Riconec/ESP8266-Wi-Fi-RFID/Docs/Diploma/_7 Перелік скорочень.docx

ПЕРЕЛІК УМОВНИХ СКОРОЧЕНЬ, ТЕРМІНІВ

Wi – Wi (англ. «wireless fidelity» - технологія, що дозволяє виконувати передачу даних на високій швидкості без використання проводів через радіо сигнал.

SoC (англ «system-on-a-chip) — дизайн електронної схеми, яка вміщує функціональні складові цілого пристрою на одній мікросхемі.

RFID (англ. radio frequency identification») - спосіб автоматичної ідентифікації об'єктів, в якому за допомогою радіосигналів зчитуються або записуються дані.

OLED (англ. «organic light emitting diode») — світлодіод, випромінюючий електролюмінісцентний шар якого складається з плівки органічної суміші.

SPI (англ. «serial peripheral interface») – послідовний периферійний інтерфейс.

I²C (англ. «inter-integrated circuit» послідовна шина даних для зв'язку інтегральних схем.

UART (англ. «universal asynchronous receiver/transmitter») – універсальний асинхронний приймач/передавач.

ASCII (англ. «american standard code for information interchange») - американський стандартний код для інформаційного обміну.

USB (англ. «universal serial bus») – універсальна послідовна шина.

ДП – друкована плата.

КП – контактна площадка.

КС – координатна сітка.

МК – мікроконтролер.

МО – монтажний отвір.

ПК – персональний комп’ютер.

Зм. Арк. № документа Підпис Дата Арк. 4 ДК01.466429.001 ПЗ
