Riconec/ESP8266-Wi-Fi-RFID/Docs/Diploma/сторінки.docx

1) RFID, I2C, SPI – 7 сторінок
2) Теорія ESP8266 – 7 сторінок
3) Анотація – 3 сторінки
4) Список скорочень – 1 сторінка

----- усього 18 сторінок + 3 А1 + 2 А4

5) Розрахунки електричні та конструкторські – 11 сторінок

---- усього 29 сторінок
