Riconec/ESP8266-Wi-Fi-RFID/Docs/Diploma/_4 ПЗ титул.docx

Пояснювальна записка
до дипломного проекту

на тему:

Київ – 20__ року
