Riconec/ESP8266-Wi-Fi-RFID/Docs/Diploma/ДОДАТОК.docx

Додаток Б

ТЕКСТ ФАЙЛУ MAIN.С

#include "stm32f10x_gpio.h"

#include "wh0802.h"

#include "menu.h"

#define RCC_APB1ENR_INIT (RCC_APB1ENR_TIM2EN | RCC_APB1ENR_TIM3EN | RCC_APB1ENR_TIM6EN)

#define RCC_APB2ENR_INIT (RCC_APB2ENR_IOPAEN | RCC_APB2ENR_IOPBEN | RCC_APB2ENR_IOPCEN | RCC_APB2ENR_AFIOEN | RCC_APB2ENR_USART1EN)

#define GPIOA_CRH_INIT 0x44442222

#define GPIOB_CRL_INIT 0x4a444444

#define GPIOB_CRH_INIT 0x4444a244

#define GPIOC_CRL_INIT 0x44424444

#define GPIOC_CRH_INIT 0x444222a2

#define AFIO_MAPR_INIT (AFIO_MAPR_TIM2_REMAP | AFIO_MAPR_TIM3_REMAP | AFIO_MAPR_USART1_REMAP)

#define USART1_BRR_INIT (0x9c4)

#define USART1_CR1_INIT (USART_CR1_UE | USART_CR1_TE | USART_CR1_RE | USART_CR1_TCIE | USART_CR1_RXNEIE)

#define EXTI_IMR_INIT 0x0000000f

#define EXTI_RTSR_INIT 0x0000000f

#define NVIC_ISER0_INIT (NVIC_ISER_SETENA_6 | NVIC_ISER_SETENA_7 | NVIC_ISER_SETENA_8 | NVIC_ISER_SETENA_9)

#define NVIC_ISER1_INIT (NVIC_ISER_SETENA_5)

uint32_t PrButton = 0;

void MOTOR_Start() {

unsigned int MHSpeed;

unsigned int MLSpeed = 240;

if (!CONTROL.Direction) {

MHSpeed = CONTROL.Speed * 24000 / 100;

TIM3->CCR4 = 23760;

}

else {

MHSpeed = CONTROL.Speed * 24000 / 100;

TIM2->CCR4 = 240;

}

GPIOC->ODR |= (1<<4);

TIM2->CR1 |= TIM_CR1_CEN;

TIM3->CR1 |= TIM_CR1_CEN;

while (MHSpeed >= MLSpeed) {

if (!CONTROL.Direction) TIM2->CCR4 = MLSpeed;

else TIM3->CCR4 = 24000 - MLSpeed;

WH0802_DelayMS(25);

MLSpeed += 240;

}

}

void MOTOR_UpdateSpeed() {

if (!CONTROL.Direction) {

TIM2->CCR4 = CONTROL.Speed * 24000 / 100;

TIM3->CCR4 = 23760;

}

else {

TIM3->CCR4 = (100 - CONTROL.Speed) * 24000 / 100;

TIM2->CCR4 = 240;

}

}

void MOTOR_Stop() {

unsigned int MHSpeed;

unsigned int MLSpeed = 240;

if (!CONTROL.Direction) {

MHSpeed = CONTROL.Speed * 24000 / 100;

TIM3->CCR4 = 23760;

}

else {

MHSpeed = CONTROL.Speed * 24000 / 100;

TIM2->CCR4 = 240;

}

while (MHSpeed >= MLSpeed) {

if (!CONTROL.Direction) TIM2->CCR4 = MHSpeed;

else TIM3->CCR4 = 24000 - MHSpeed;

WH0802_DelayMS(25);

MHSpeed -= 240;

}

GPIOC->ODR &= ~(1<<4);

TIM2->CR1 &= ~TIM_CR1_CEN;

TIM3->CR1 &= ~TIM_CR1_CEN;

}

void MENU_UpdateSpeed(unsigned int Speed) {

CONTROL.VALUE[0][0] = '>';

CONTROL.VALUE[0][4] = (Speed / 10) | 0x30;

CONTROL.VALUE[0][5] = (Speed % 10) | 0x30;

MOTOR_UpdateSpeed();

}

void MENU_UpdateDirection(unsigned int Direction) {

if (!Direction) {

CONTROL.VALUE[1][0] = '>'; CONTROL.VALUE[1][1] = 'f';

CONTROL.VALUE[1][2] = 'o'; CONTROL.VALUE[1][3] = 'r';

CONTROL.VALUE[1][4] = 'w'; CONTROL.VALUE[1][5] = 'a';

CONTROL.VALUE[1][6] = 'r'; CONTROL.VALUE[1][7] = 'd';

}

else {

CONTROL.VALUE[1][0] = '>'; CONTROL.VALUE[1][1] = 'r';

CONTROL.VALUE[1][2] = 'e'; CONTROL.VALUE[1][3] = 'v';

CONTROL.VALUE[1][4] = 'e'; CONTROL.VALUE[1][5] = 'r';

CONTROL.VALUE[1][6] = 's'; CONTROL.VALUE[1][7] = 'e';

}

}

void MENU_Update(unsigned int Button) {

if (Button == 1) {

if (!CONTROL.ItemValue) {

if (CONTROL.CurItem) CONTROL.CurItem = 0;

else CONTROL.CurItem = 1;

}

else {

if (CONTROL.CurItem == 0) {

if (CONTROL.Speed > 5) CONTROL.Speed -= 5;

else CONTROL.Speed = 5;

MENU_UpdateSpeed(CONTROL.Speed);

}

else {

if (CONTROL.Direction) CONTROL.Direction = 0;

else CONTROL.Direction = 1;

MENU_UpdateDirection(CONTROL.Direction);

}

}

}

if (Button == 2) {

if (!CONTROL.ItemValue) {

CONTROL.ItemValue = 1;

CONTROL.ITEM[CONTROL.CurItem][0] = ' ';

CONTROL.VALUE[CONTROL.CurItem][0] = '>';

}

else {

CONTROL.ItemValue = 0;

CONTROL.ITEM[CONTROL.CurItem][0] = '>';

CONTROL.VALUE[CONTROL.CurItem][0] = ' ';

}

}

if (Button == 3) {

if (!CONTROL.ItemValue) {

if (!CONTROL.CurItem) CONTROL.CurItem = 1;

else CONTROL.CurItem = 0;

}

else {

if (CONTROL.CurItem == 0) {

if (CONTROL.Speed < 95) CONTROL.Speed += 5;

else CONTROL.Speed = 95;

MENU_UpdateSpeed(CONTROL.Speed);

}

else {

if (CONTROL.TurnOn) MOTOR_Stop();

if (CONTROL.Direction) CONTROL.Direction = 0;

else CONTROL.Direction = 1;

MENU_UpdateDirection(CONTROL.Direction);

if (CONTROL.TurnOn) MOTOR_Start();

}

}

}

if (Button == 4) {

if (CONTROL.TurnOn) {

CONTROL.TurnOn = 0;

MOTOR_Stop();

}

else {

CONTROL.TurnOn = 1;

MOTOR_Start();

}

}

if (Button == 5) {

EXTI->IMR &= ~EXTI_IMR_INIT;

if (!CONTROL.TurnOn) {

CONTROL.Direction = 0;

MENU_UpdateDirection(CONTROL.Direction);

CONTROL.Speed = 5;

MENU_UpdateSpeed(CONTROL.Speed);

CONTROL.TurnOn = 1;

MOTOR_Start();

}

}

if (Button == 6) {

EXTI->IMR |= EXTI_IMR_INIT;

if (CONTROL.TurnOn) {

CONTROL.TurnOn = 0;

MOTOR_Stop();

}

}

if (Button == 7) {

if (CONTROL.TurnOn) MOTOR_Stop();

if (CONTROL.Direction) CONTROL.Direction = 0;

else CONTROL.Direction = 1;

MENU_UpdateDirection(CONTROL.Direction);

if (CONTROL.TurnOn) MOTOR_Start();

}

if (Button == 8) {

if ((CONTROL.Speed >= 5) && (CONTROL.Speed <= 95))

MENU_UpdateSpeed(CONTROL.Speed);

}

}

void main(void) {

RCC->APB1ENR |= RCC_APB1ENR_INIT;

RCC->APB2ENR |= RCC_APB2ENR_INIT;

GPIOA->CRH = GPIOA_CRH_INIT;

GPIOB->CRL = GPIOB_CRL_INIT;

GPIOB->CRH = GPIOB_CRH_INIT;

GPIOC->CRL = GPIOC_CRL_INIT;

GPIOC->CRH = GPIOC_CRH_INIT;

AFIO->MAPR = AFIO_MAPR_INIT;

USART1->BRR = USART1_BRR_INIT;

USART1->CR1 = USART1_CR1_INIT;

EXTI->IMR = EXTI_IMR_INIT;

EXTI->RTSR = EXTI_RTSR_INIT;

NVIC->ISER[0] = NVIC_ISER0_INIT;

NVIC->ISER[1] = NVIC_ISER1_INIT;

GPIOC->ODR &= ~(1<<4);

GPIOC->ODR |= (1<<8);

GPIOB->ODR |= (1<<10);

TIM2->CR1 |= TIM_CR1_ARPE;

TIM2->CCMR2 |= (TIM_CCMR2_OC4PE | TIM_CCMR2_OC4M_2 | TIM_CCMR2_OC4M_1);

TIM2->ARR = 24000;

TIM2->CCR4 = 1200;

TIM2->CCER |= (TIM_CCER_CC4E);

TIM3->CR1 |= TIM_CR1_ARPE;

TIM3->CCMR2 |= (TIM_CCMR2_OC4PE | TIM_CCMR2_OC4M_2 | TIM_CCMR2_OC4M_1);

TIM3->ARR = 24000;

TIM3->CCR4 = 22800;

TIM3->CCER |= (TIM_CCER_CC4E | TIM_CCER_CC4P);

WH0802_Init();

WH0802_WriteString(CONTROL.ITEM[CONTROL.CurItem], 8, 1);

WH0802_WriteString(CONTROL.VALUE[CONTROL.CurItem], 8, 2);

while (1) {

if (PrButton) {

MENU_Update(PrButton);

WH0802_WriteString(CONTROL.ITEM[CONTROL.CurItem], 8, 1);

WH0802_WriteString(CONTROL.VALUE[CONTROL.CurItem], 8, 2);

PrButton = 0;

}

}

}

void EXTI0_IRQHandler(void) {

EXTI->IMR &= ~EXTI_IMR_MR0;

WH0802_DelayMS(20);

if ((GPIOA->IDR)&(GPIO_Pin_0)) PrButton = 1;

EXTI->PR |= EXTI_PR_PR1;

EXTI->IMR |=(EXTI_IMR_MR0);

}

void EXTI1_IRQHandler(void) {

EXTI->IMR &= ~EXTI_IMR_MR1;

WH0802_DelayMS(20);

if ((GPIOA->IDR)&(GPIO_Pin_1)) PrButton = 2;

EXTI->PR |= EXTI_PR_PR1;

EXTI->IMR |= (EXTI_IMR_MR1);

}

void EXTI2_IRQHandler(void) {

EXTI->IMR&= ~EXTI_IMR_MR2;

WH0802_DelayMS(20);

if ((GPIOA->IDR)&(GPIO_Pin_2)) PrButton = 3;

EXTI->PR|= EXTI_PR_PR2;

EXTI->IMR|=(EXTI_IMR_MR2);

}

void EXTI3_IRQHandler(void) {

EXTI->IMR&= ~EXTI_IMR_MR3;

WH0802_DelayMS(20);

if ((GPIOA->IDR)&(GPIO_Pin_3)) PrButton = 4;

EXTI->PR|= EXTI_PR_PR3;

EXTI->IMR|=(EXTI_IMR_MR3);

}

void USART1_IRQHandler(void) {

unsigned int USARTData;

if (USART1->SR & USART_SR_RXNE) {

USART1->SR &= ~USART_SR_RXNE;

USARTData = USART1->DR;

if (USARTData == 0x20) PrButton = 5;

if (USARTData == 0x40) PrButton = 7;

if (USARTData == 0x60) PrButton = 6;

if ((USARTData & 0xe0) == 0x80) {

CONTROL.Speed = (USARTData & 0x1f) * 5;

PrButton = 8;

}

}

if (USART1->SR & USART_SR_TC) {

USART1->SR &= ~USART_SR_TC;

}

}

Додаток В

ТЕКСТ ФАЙЛУ MENU.H

#ifndef _MENU_

#define _MENU_

struct _control{

unsigned char ITEM [2][8];

unsigned char VALUE [2][8];

unsigned int CurItem;

unsigned int TurnOn;

unsigned int Speed;

unsigned int Direction;

unsigned int ItemValue;

};

struct _control CONTROL = {">SPEED: ", ">MT_DIR:", " dc=05% ", " forward", 0, 0, 5, 0, 0};

#endif //!_MENU_

Додаток Г

ТЕКСТ ФАЙЛУ WH0802.H

#ifndef _WH0802_

#define _WH0802_

typedef enum {false = 0, true = 1} bool;

void WH0802_DelayMS(unsigned int Delay);

void WH0802_DelayUS(unsigned int Delay);

void WH0802_Init();

void WH0802_SendDC(unsigned char Data, bool DC);

void WH0802_WriteString(unsigned char* String, unsigned int Length, unsigned int Row);

#endif //!_WH0802_

Додаток Д

ТЕКСТ ФАЙЛУ WH0802.C

#include "stm32f10x_gpio.h"

#include "wh0802.h"

#define DATA_PORT GPIOA->ODR

#define COM_PORT GPIOC->ODR

#define DB4 (1<<8)

#define DB5 (1<<9)

#define DB6 (1<<10)

#define DB7 (1<<11)

#define RS (1<<10)

#define RW (1<<11)

#define E (1<<12)

#define F_APB1 24000000

#define WH0802_TIM TIM6

void WH0802_DelayMS(unsigned int Delay) {

WH0802_TIM->PSC = F_APB1/1000+1;

WH0802_TIM->ARR = Delay;

WH0802_TIM->EGR |= TIM_EGR_UG;

WH0802_TIM->CR1 |= TIM_CR1_CEN|TIM_CR1_OPM;

while (WH0802_TIM->CR1&TIM_CR1_CEN!=0);

}

void WH0802_DelayUS(unsigned int Delay) {

WH0802_TIM->PSC = F_APB1/1000000+1;

WH0802_TIM->ARR = Delay;

WH0802_TIM->EGR |= TIM_EGR_UG;

WH0802_TIM->CR1 |= TIM_CR1_CEN|TIM_CR1_OPM;

while (WH0802_TIM->CR1&TIM_CR1_CEN!=0);

}

void WH0802_SendDC(unsigned char Data, bool DC) {

if (DC) COM_PORT |= RS;

else COM_PORT &= ~ RS;

DATA_PORT &= ~ (DB4 | DB5 | DB6 | DB7);

if (Data & (1<<7)) DATA_PORT |= DB7;

if (Data & (1<<6)) DATA_PORT |= DB6;

if (Data & (1<<5)) DATA_PORT |= DB5;

if (Data & (1<<4)) DATA_PORT |= DB4;

COM_PORT |= E;

WH0802_DelayUS(2);

COM_PORT &= ~E;

WH0802_DelayUS(10);

DATA_PORT &= ~ (DB4 | DB5 | DB6 | DB7);

if (Data & (1<<3)) DATA_PORT |= DB7;

if (Data & (1<<2)) DATA_PORT |= DB6;

if (Data & (1<<1)) DATA_PORT |= DB5;

if (Data & (1<<0)) DATA_PORT |= DB4;

COM_PORT |= E;

WH0802_DelayUS(2);

COM_PORT &= ~E;

WH0802_DelayUS(40);

}

void WH0802_WriteString(unsigned char* String, unsigned int Length, unsigned int Row) {

unsigned int i;

if ((Row == 1) || (Row == 2)) {

if (Row == 1) WH0802_SendDC(0x80, 0);

if (Row == 2) WH0802_SendDC(0xC0, 0);

for (i = 0; i < Length; ++i) WH0802_SendDC(String[i], 1);

}

}

void WH0802_Init() {

COM_PORT &= ~RW;

WH0802_DelayMS(50);

WH0802_SendDC(0x30, 0);//0b001/DL/0000, DL = 1

WH0802_DelayUS(50);

WH0802_SendDC(0x28, 0);//0b0010/N/F/00, N = 1, F = 0

WH0802_DelayUS(50);

WH0802_SendDC(0x28, 0);//0b0010/N/F/00, N = 1, F = 0

WH0802_DelayUS(50);

WH0802_SendDC(0x0c, 0);//0b0000/1/D/C/B, D = 1, C = 1, B = 0

WH0802_DelayUS(50);

WH0802_SendDC(0x01, 0);//clear display

WH0802_DelayMS(2);//delay 2 ms

WH0802_SendDC(0x06, 0);//0x0000 01 I/D SH, I/D = 1, SH = 0

}

Зм. Арк. № документа Підпис Дата Арк. 92 ДК01.466429.001 ПЗ
