Riconec/ESP8266-Wi-Fi-RFID/Docs/Diploma/Other/mlx1.png

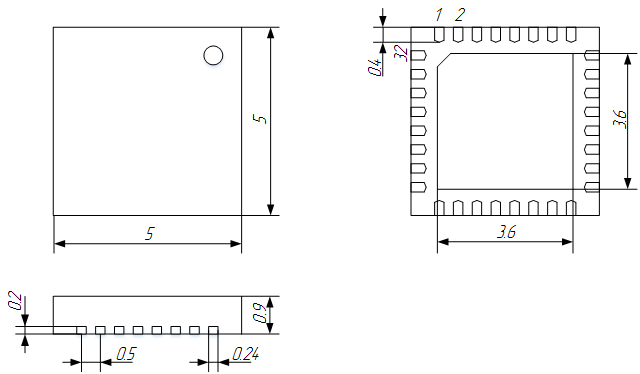
Docs/Diploma/Other/mlx1.png
