Riconec/ESP8266-Wi-Fi-RFID/Docs/Diploma/Other/mlx2.png

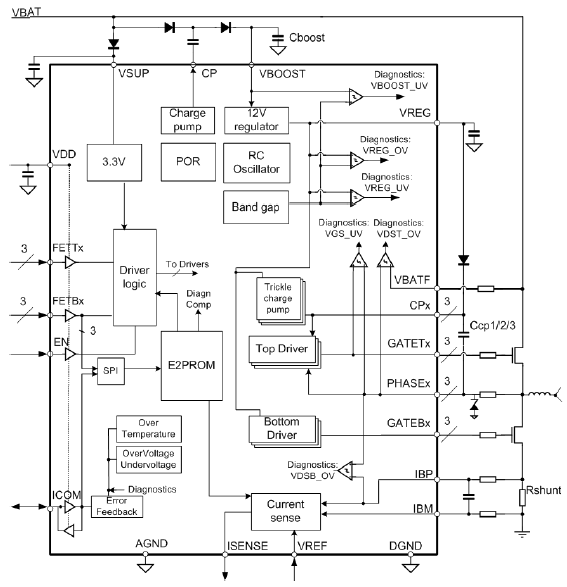
Docs/Diploma/Other/mlx2.png
