Riconec/ESP8266-Wi-Fi-RFID/Docs/Diploma/Other/mlx3.png

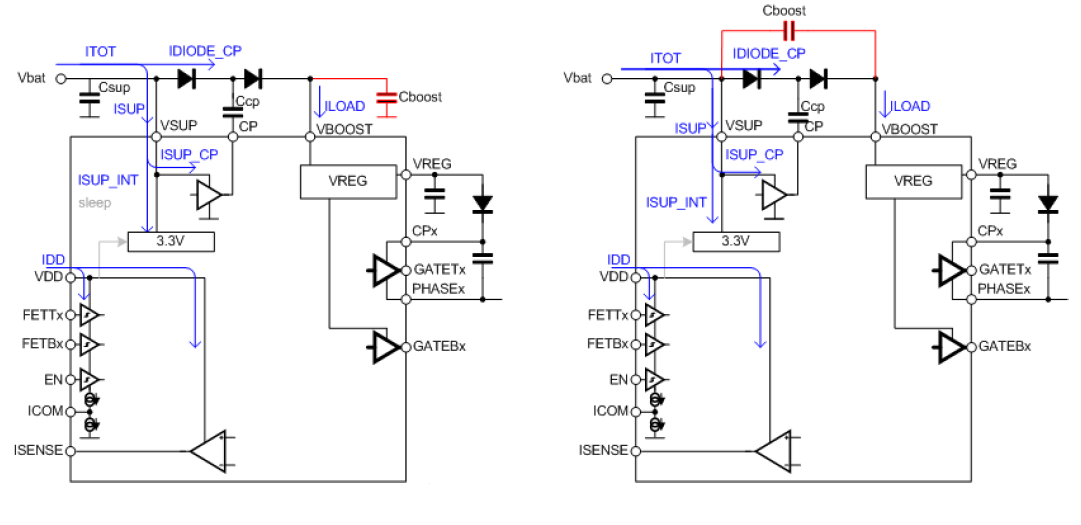
Docs/Diploma/Other/mlx3.png
