Riconec/ESP8266-Wi-Fi-RFID/Docs/Diploma/Other/mlx4.png

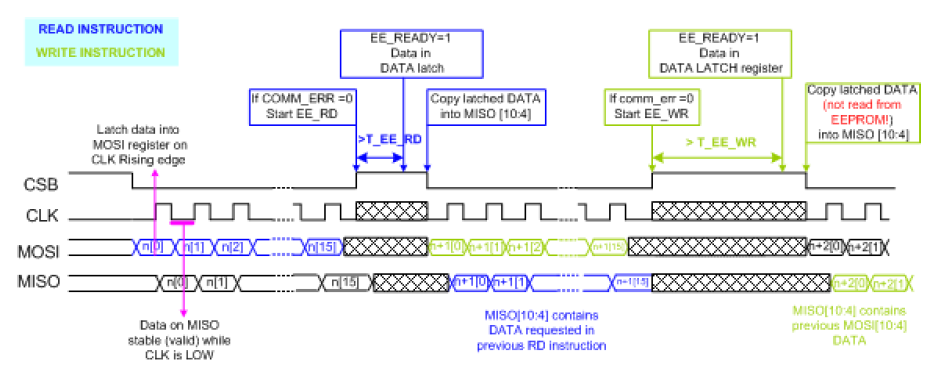
Docs/Diploma/Other/mlx4.png
