Riconec/ESP8266-Wi-Fi-RFID/Docs/Diploma/Other/mlx5.png

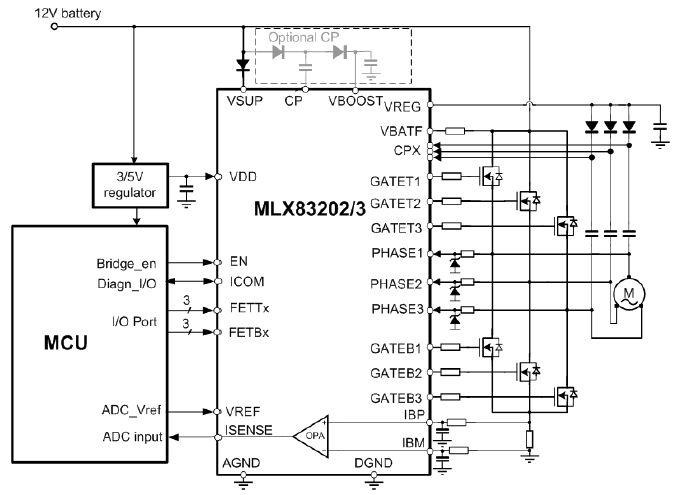
Docs/Diploma/Other/mlx5.png
