Riconec/ESP8266-Wi-Fi-RFID/Docs/Diploma/Other/room.png

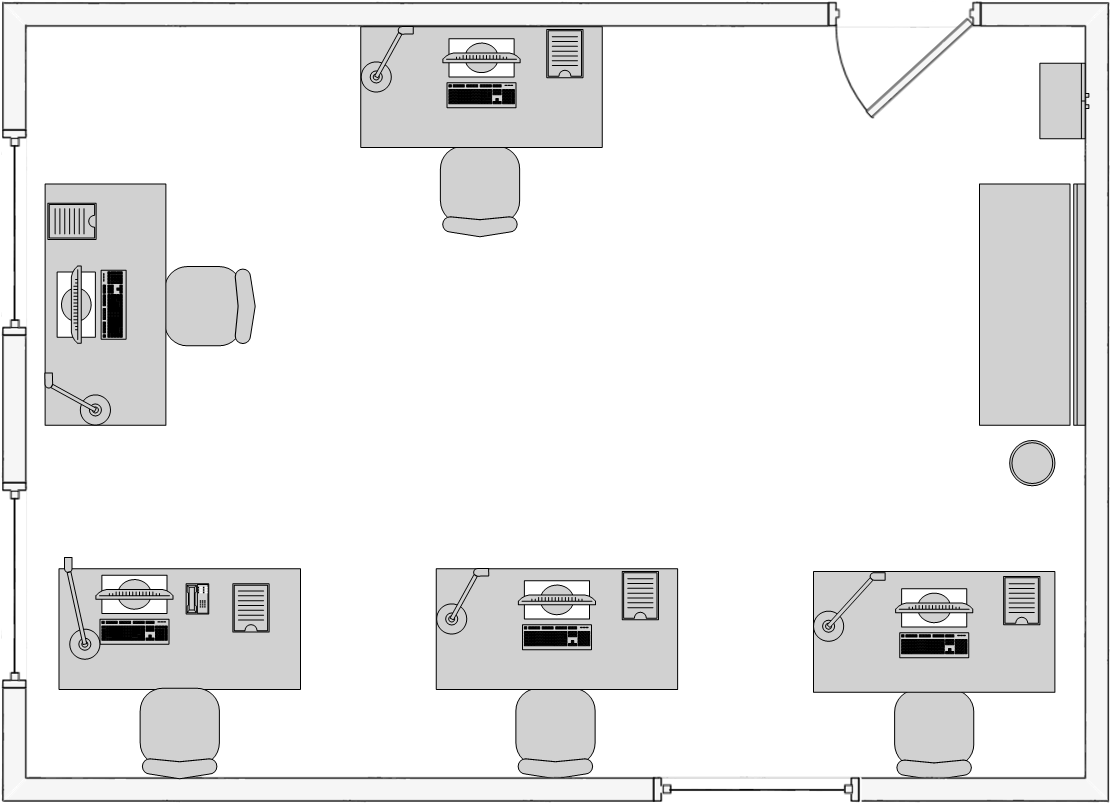
Docs/Diploma/Other/room.png
