Riconec/ESP8266-Wi-Fi-RFID/PCB/ESP RFID/kpi_0.bmp

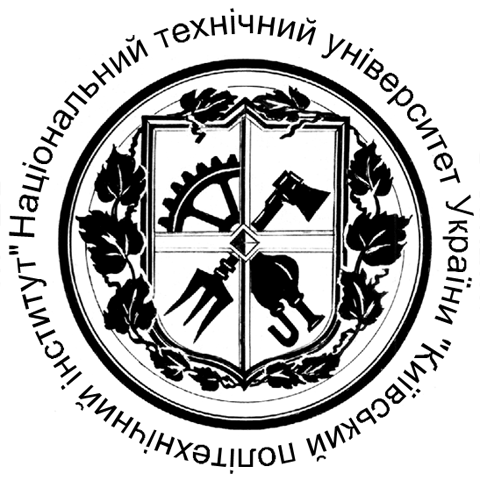
PCB/ESP RFID/kpi_0.bmp
