Riconec/ESP8266-Wi-Fi-RFID/PCB/ESP RFID/vNxCmmRR-F8____.bmp

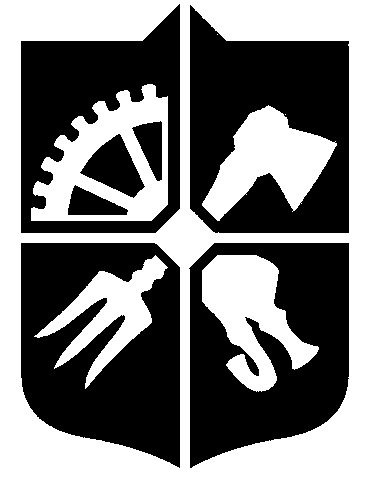
PCB/ESP RFID/vNxCmmRR-F8____.bmp
