Riconec/ESP8266-Wi-Fi-RFID/PCB/ESP RFID/vNxCmmRR-F8____.jpg

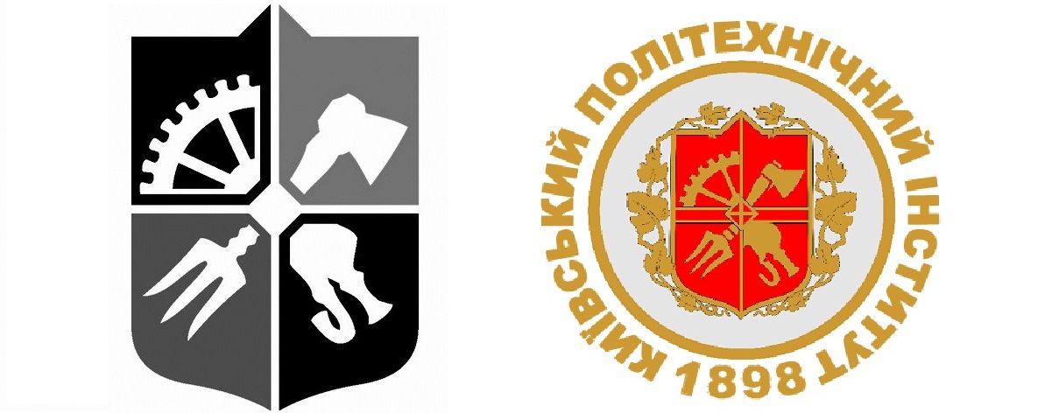
PCB/ESP RFID/vNxCmmRR-F8____.jpg
