Riconec/ESP8266-Wi-Fi-RFID/Docs/Drawings, Calculations/перелік.xlsx

Sheet: Sheet1
Позиційне позначення |  |  | Найменування |  |  |  | Кіл-ть |  | Примітка
 |  |  | Енкодер механічний
BR1 |  |  | ENC13017SF-12PS |  |  |  | 1 |  | ALPHA
 |  |  | Конденсатори керамічні
C1 |  |  | CL10A106KQ8NNNC 10uF, 50V, ±10% |  |  |  | 1 |  | Samsung
C2 |  |  | CL10B104KB8NNNC 100nF, 50V, ±10% |  |  |  | 1
C3 |  |  | CL10A106KQ8NNNC 10uF, 50V, ±10% |  |  |  | 1
C4 |  |  | CL10B104KB8NNNC 100nF, 50V, ±10% |  |  |  | 1
C5 |  |  | CL10A106KQ8NNNC 10uF, 50V, ±10% |  |  |  | 1
C6 |  |  | CL10B104KB8NNNC 100nF, 50V, ±10% |  |  |  | 1
C7-C9 |  |  | CL10A475KQ8NNNC 4,7uF, 50V, ±10% |  |  |  | 3
C10-C12 |  |  | CL10B104KB8NNNC 100nF, 50V, ±10% |  |  |  | 3
C13 |  |  | CL10A475KQ8NNNC 4,7uF, 50V, ±10% |  |  |  | 1
C14 |  |  | CL10C102JB8NNNC 1nF, 50V, ±10% |  |  |  | 1
C15 |  |  | CL10A105KP8NNNC 1uF, 50V, ±10% |  |  |  | 1
C16 |  |  | CL10B104KB8NNNC 100nF, 50V, ±10% |  |  |  | 1
C17,C18 |  |  | CL10B103KB8NNNC 10nF, 50V, ±10% |  |  |  | 2
C19 |  |  | CL10B104KB8NNNC 100nF, 50V, ±10% |  |  |  | 1
 |  |  | Мікросхеми
DD1 |  |  | CP2104-F03-GM |  |  |  | 1 |  | Cypress
DD2 |  |  | MCP1725-3302E |  |  |  | 1 |  | Microchip
DD3 |  |  | MCP73831T |  |  |  | 1
DD4 |  |  | ESP-12E |  |  |  | 1 |  | Espressif
DD5 |  |  | Atmega8A-MUR |  |  |  | 1 |  | ATMEL
DD6 |  |  | PCF8563 |  |  |  | 1 |  | NXP
 |  |  |  |  |  | ДК21.468213.001 ПЕ
Зм. | Арк. | № документа |  | Підпис | Дата
Розробив |  | Поправка Є.І. |  |  |  |  |  | Літера |  | Аркуш | Аркушів
Перевірив |  | Адаменко І.О. |  |  |  |  |  |  |  | 1 | 2
 |  |  |  |  |  | Перелік елементів |  | НТУУ "КПІ", ФЕЛ, гр. ДК-21
Н. контр. |  | Лисенко О.І.
Затверд. |  | Лисенко О.М.

Sheet: Sheet2
Позиційне позначення |  |  | Найменування |  |  |  | Кіл-ть | Примітка
 |  |  | П'єзовипромінювач
HF1 |  |  | YHE12-03 |  |  |  | 1 | Huayu
 |  |  | Світлодіоди
HL1 |  |  | KP-1608MBC |  |  |  | 1 | Kingbright
 |  |  | Резистори
R1 |  |  | ERJ-3EKF2402V 24k, 100mW, ±5% |  |  |  | 1 | Panasonic
R2, R3 |  |  | ERJ-3EKF1002V 10k, 100mW, ±5% |  |  |  | 2
R4 |  |  | ERJ-3EKF4702V 47k, 100mW, ±5% |  |  |  | 1
R5,R6 |  |  | ERJ-3EKF5101V 5,1k, 100mW, ±5% |  |  |  | 2
R7 |  |  | ERJ-3EKF1003V 100k, 100mW, ±5% |  |  |  | 1
R8 |  |  | ERJ-3EKF4700V 470, 100mW, ±5% |  |  |  | 1
R9-R16 |  |  | ERJ-3EKF1002V 10k, 100mW, ±5% |  |  |  | 8
R17 |  |  | ERJ-3EKF5102V 51k, 100mW, ±5% |  |  |  | 1
R18 |  |  | ERJ-3EKF1003V 100k, 100mW, ±5% |  |  |  | 1
R19-R24 |  |  | ERJ-3EKF1002V 10k, 100mW, ±5% |  |  |  | 6
 |  |  | Транзистори
VT1, VT2 |  |  | BC817 |  |  |  | 2 | NXP
 |  |  | Роз'єми
XS1 |  |  | SD-47346-001 |  |  |  | 1 | Molex
XS2 |  |  | PBS-2 |  |  |  | 1 | Connfly
XS3 |  |  | PBS-4 |  |  |  | 1
XS4 |  |  | PBS-8 |  |  |  | 1
XS5 |  |  | MR07-AP20330 |  |  |  | 1 | ATOM
 |  |  | Кварцовий резонатор
ZQ1 |  |  | KХ-26 32768Hz |  |  |  | 1 | Geyer
 |  |  |  |  |  | ДК21.468213.001 ПЕ |  |  | Арк.
 |  |  |  |  |  |  |  |  | 2
Зм. | Арк. | № документа |  | Підпис | Дата

Sheet: Sheet1 (2)
Позиційне позначення |  |  | Найменування |  |  |  | Кіл-ть |  | Примітка
 |  |  | Енкодер механічний
BR1 |  |  | ENC13017SF-12PS |  |  |  | 1 |  | ALPHA
 |  |  | Конденсатори керамічні
C1 |  |  | CL10A106KQ8NNNC 10uF, 50V, ±10% |  |  |  | 1 |  | Samsung
C2 |  |  | CL10B104KB8NNNC 100nF, 50V, ±10% |  |  |  | 1
C3 |  |  | CL10A106KQ8NNNC 10uF, 50V, ±10% |  |  |  | 1
C4 |  |  | CL10B104KB8NNNC 100nF, 50V, ±10% |  |  |  | 1
C5 |  |  | CL10A106KQ8NNNC 10uF, 50V, ±10% |  |  |  | 1
C6 |  |  | CL10B104KB8NNNC 100nF, 50V, ±10% |  |  |  | 1
C7-C9 |  |  | CL10A475KQ8NNNC 4,7uF, 50V, ±10% |  |  |  | 3
C10-C12 |  |  | CL10B104KB8NNNC 100nF, 50V, ±10% |  |  |  | 3
C13 |  |  | CL10A475KQ8NNNC 4,7uF, 50V, ±10% |  |  |  | 1
C14 |  |  | CL10C102JB8NNNC 1nF, 50V, ±10% |  |  |  | 1
C15 |  |  | CL10A105KP8NNNC 1uF, 50V, ±10% |  |  |  | 1
C16 |  |  | CL10B104KB8NNNC 100nF, 50V, ±10% |  |  |  | 1
C17,C18 |  |  | CL10B103KB8NNNC 10nF, 50V, ±10% |  |  |  | 2
C19 |  |  | CL10B104KB8NNNC 100nF, 50V, ±10% |  |  |  | 1
 |  |  | Мікросхеми
DD1 |  |  | CP2104-F03-GM |  |  |  | 1 |  | Cypress
DD2 |  |  | MCP1725-3302E |  |  |  | 1 |  | Microchip
DD3 |  |  | MCP73831T |  |  |  | 1
DD4 |  |  | ESP-12E |  |  |  | 1 |  | Espressif
DD5 |  |  | Atmega8A-MUR |  |  |  | 1 |  | ATMEL
DD6 |  |  | PCF8563 |  |  |  | 1 |  | NXP
 |  |  |  |  |  | ДК21.468213.001 ПЕ
Зм. | Арк. | № документа |  | Підпис | Дата
Розробив |  | Поправка Є.І. |  |  |  |  |  | Літера |  | Аркуш | Аркушів
Перевірив |  | Адаменко І.О. |  |  |  |  |  |  |  | 1 | 3
 |  |  |  |  |  | Перелік елементів |  | НТУУ "КПІ", ФЕЛ, гр. ДК-01
Н. контр. |  | Лисенко О.І.
Затверд. |  | Лисенко О.М.

Sheet: Лист2
C1 | CL10A106KQ8NNNC 10uF, 50V, ±10% | 1 | Samsung
C2 | CL10B104KB8NNNC 100nF, 50V, ±10% | 1
C3 | CL10A106KQ8NNNC 10uF, 50V, ±10% | 1
C4 | CL10B104KB8NNNC 100nF, 50V, ±10% | 1
C5 | CL10A106KQ8NNNC 10uF, 50V, ±10% | 1
C6 | CL10B104KB8NNNC 100nF, 50V, ±10% | 1
C7-C9 | CL10A475KQ8NNNC 4,7uF, 50V, ±10% | 3
C10-C12 | CL10B104KB8NNNC 100nF, 50V, ±10% | 3
C13 | CL10A475KQ8NNNC 4,7uF, 50V, ±10% | 1
C14 | CL10C102JB8NNNC 1nF, 50V, ±10% | 1
C15 | CL10A105KP8NNNC 1uF, 50V, ±10% | 1
C16 | CL10B104KB8NNNC 100nF, 50V, ±10% | 1
C17,C18 | CL10B103KB8NNNC 10nF, 50V, ±10% | 2
C19 | CL10B104KB8NNNC 100nF, 50V, ±10% | 1
 | Резистори
R1 | ERJ6GEYJ104V | 1 | 100 кОм
R2 | MC 56k 0.1W 0805 5% | 1 | 56 кОм
R3 | ERJ6GEYJ472V | 1 | 4.7 кОм
R4 | MC 680k 0.1W 0805 5% | 1 | 680 кОм
R5 | ERJ6GEYJ471V | 1 | 470 Ом
R6 | ERJ6GEYJ103V | 1 | 10 кОм
R7 | MC0805S8F0000T5E | 1 | 0 Ом
R8 | ERJ6GEYJ271V | 1 | 270 Ом
R9 | RM-065 | 1 | 22 кОм
R10 | ERJ6GEYJ271V | 1 | 270 Ом
R11,R12 | ERJ6GEYJ103V | 2 | 10 кОм
R13 | MC 1M 0.1W 0805 5% | 1 | 1 МОм
R14 | ERJ6GEYJ103V | 1 | 10 кОм
R15 | MC 1M 0.1W 0805 5% | 1 | 1 МОм
R16 | MC0805S8F0000T5E | 1 | 0 Ом
R17,R18 | ERJ6GEYJ103V | 2 | 10 кОм
R19 | MC0805S8F0000T5E | 1 | 0 Ом
R20 | ERJ6GEYJ220V | 1 | 22 Ом
R21-R23 | MC 3k 0.1W 0805 5% | 3 | 3 кОм
R24-R26 | MC 33k 0.1W 0805 5% | 3 | 33 кОм
R27 | MC 36k 0.1W 0805 5% | 1 | 36 кОм
R28-R30 | ERJ6GEYJ4R7V | 3 | 4.7 Ом

Sheet: Sheet3
Позиційне позначення |  |  | Найменування |  |  |  | Кількість | Примітка
R31,R32 |  |  | MC 36k 0.1W 0805 5% |  |  |  | 2 | 36 кОм
R33 |  |  | ERJ6GEYJ471V |  |  |  | 1 | 470 Ом
R34-R37 |  |  | MC 10R 0.1W 0805 5% |  |  |  | 4 | 10 Ом
R38,R39 |  |  | MC 10R 0.1W 0805 5% |  |  |  | 2 | 10 Ом
R40-R42 |  |  | ERJ6GEYJ104V |  |  |  | 3 | 100 кОм
R43,R44 |  |  | MC 10R 0.1W 0805 5% |  |  |  | 2 | 10 Ом
R45 |  |  | 4723 SMD 0R0022 |  |  |  | 1 | 0.0022 Ом
R46-R51 |  |  | MC0805S8F0000T5E |  |  |  | 6 | 0 Ом
 |  |  | Джампери
SB1-SB37 |  |  | MC34737 |  |  |  | 37 | 3 вивода
 |  |  | Кнопки
SW1-SW5 |  |  | DTS-61 |  |  |  | 5
 |  |  | Діоди
VD1-VD5 |  |  | BAS316 |  |  |  | 5
VD6 |  |  | PMEG3010EJ |  |  |  | 1
VD7 |  |  | BAS316 |  |  |  | 1
VD8 |  |  | PMEG3010EJ |  |  |  | 1
VD9 |  |  | BAS316 |  |  |  | 1
VD10 |  |  | PMEG3010EJ |  |  |  | 1
 |  |  | Транзистори
VT1 |  |  | BC848C |  |  |  | 1
VT2 |  |  | IPD90N03S4L-03C |  |  |  | 1
VT3-VT8 |  |  | IPD90N04S3-04 |  |  |  | 6
 |  |  | Роз'єми
XS1 |  |  | MC34737 |  |  |  | 1 | 8 х 4 виводів
XS2 |  |  | USB/M-1J |  |  |  | 1 | USB роз'єм
XS3 |  |  | MC000034 |  |  |  | 1 | 2 вивода
 |  |  |  |  |  | ДК01.466429.009 ПЕ |  |  | Арк.
 |  |  |  |  |  |  |  |  | 3
Зм. | Арк. | № документа |  | Підпис | Дата

Sheet: Лист1
Позиційне позначення |  |  | Найменування |  |  |  | Кількість | Примітка
XS4 |  |  | MC34737 |  |  |  | 1 | 7 х 2 та 6 виводів
XS5 |  |  | MC34737 |  |  |  | 1 | 8 х 4 виводів
XS6 |  |  | MC000035 |  |  |  | 1 | 3 вивода
 |  |  |  |  |  | ДК01.466429.009 ПЕ |  |  | Арк.
 |  |  |  |  |  |  |  |  | 4
Зм. | Арк. | № документа |  | Підпис | Дата
