Riconec/ESP8266-Wi-Fi-RFID/(list of files, cad)

Other CAD files:
Docs/Drawings, Calculations/constr.dwg
Docs/Drawings, Calculations/layout_recover.dwg
