Riconec/ESP8266-Wi-Fi-RFID/PCB/ESP RFID/schematic.pdf

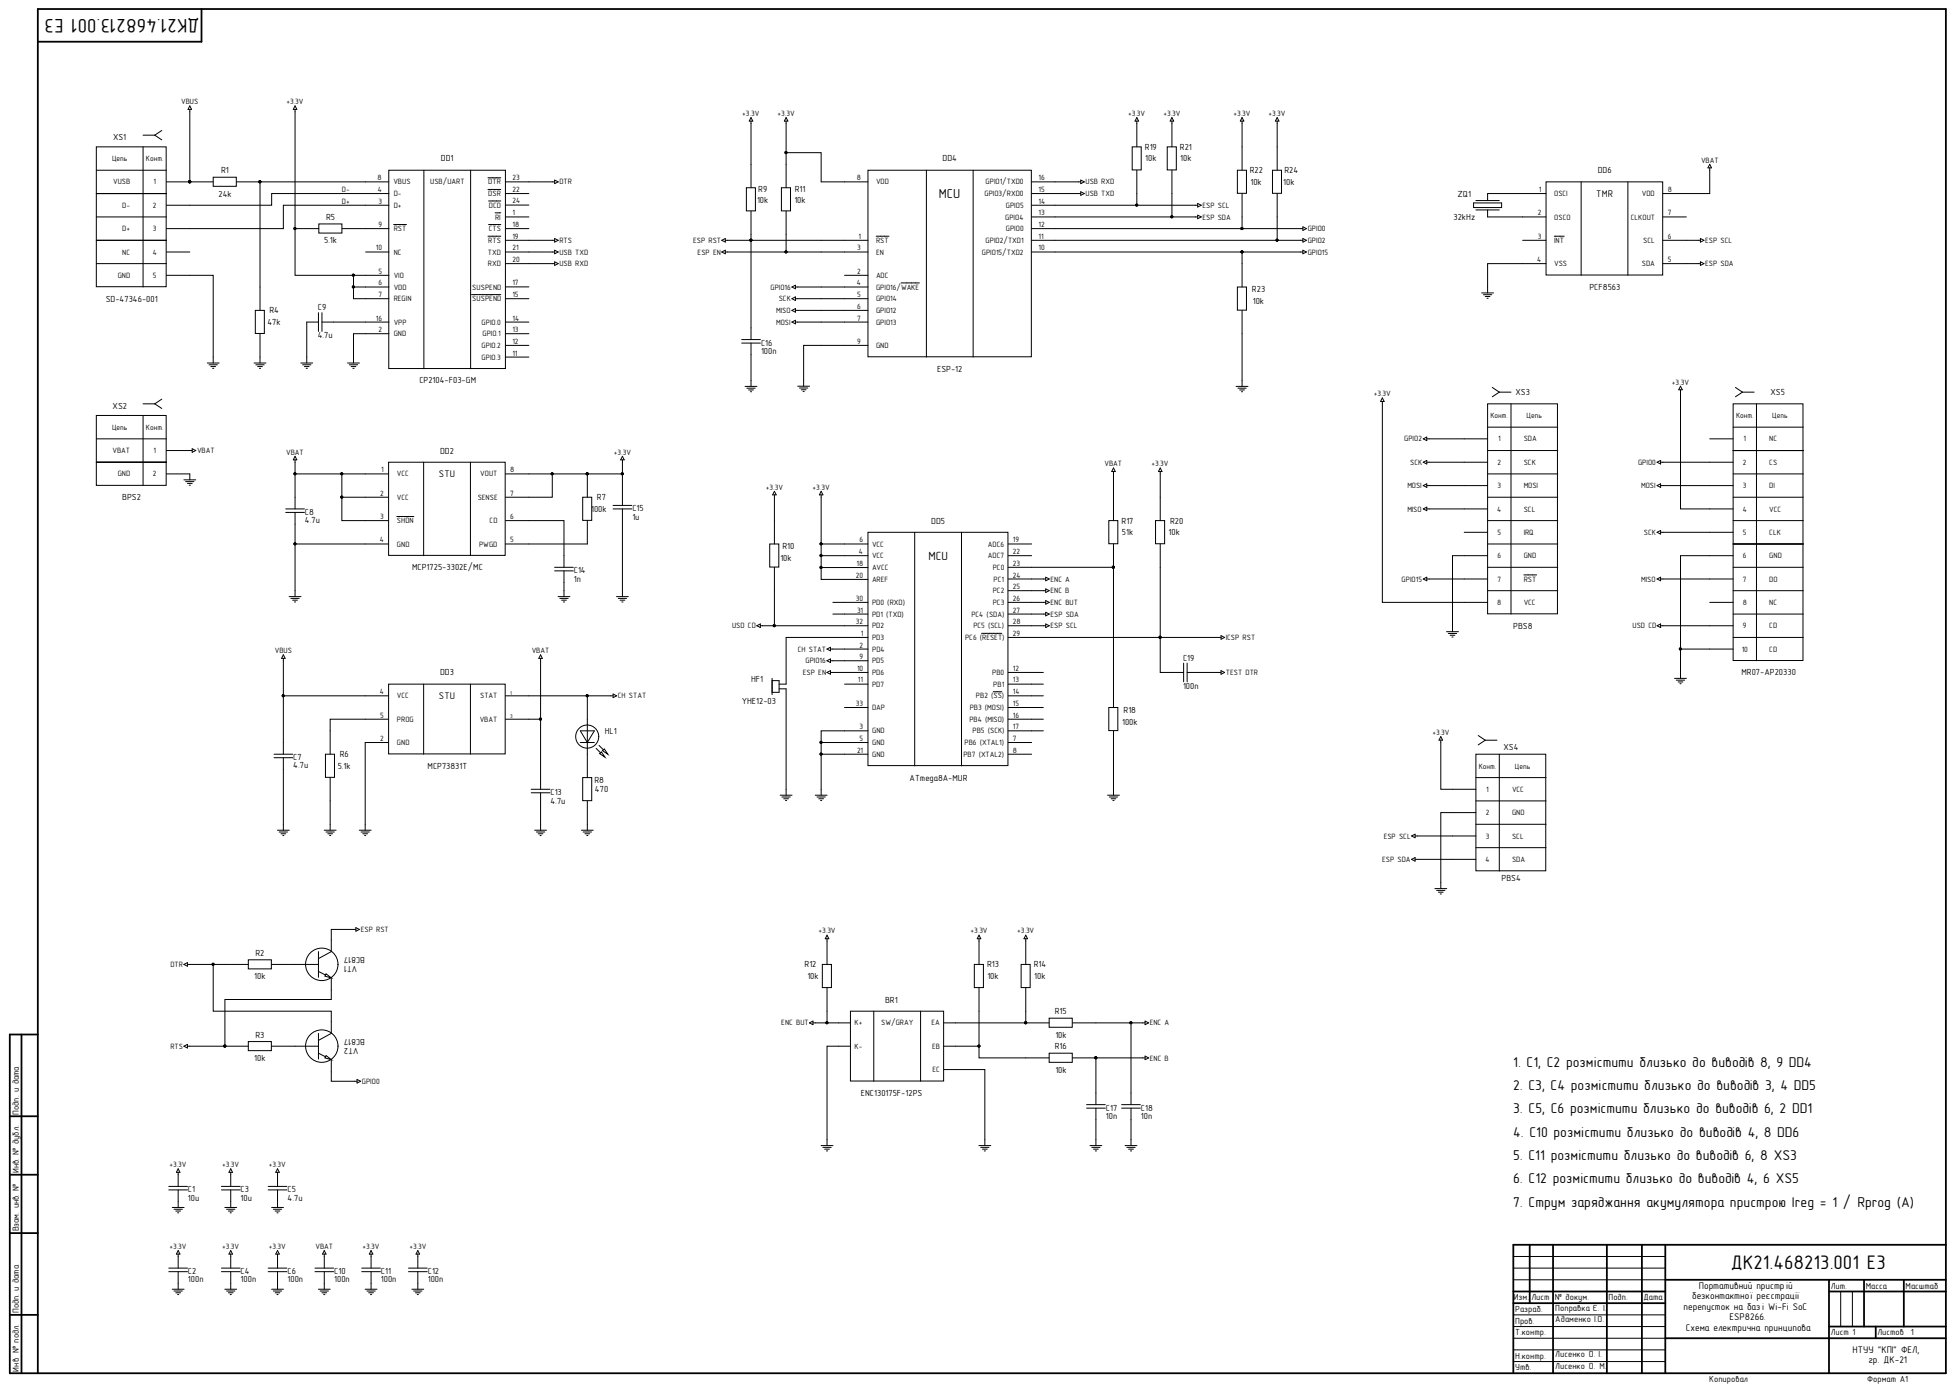
[picture p46: page 1]

Цепь | Конт | .

VBA T | 12

VCC GND | S T U | STA T VBA T | 3 PROG

GND 21 | 8

Конт | . Цепь
GND VCC

SCL

SDA

істити близько до вивод

Инв. № подл. Инв. № дубл. Подп. и дата Взам. инв. № Подп. и дата

Изм | . Лист | № докум . | Подп . | Дата | | | . | Масса | Масштаб 1

Портативний пристр і й безконтактно ї ре єстрації перепусток на баз і Wi-Fi SoC ES P 8266. Схем а електрична принципова | Лит

Разраб . | | Поправка Є . | І .
Пров . | | Адаменко І . О .
Т .контр . | | | | | Лист | Листов 1

Н .контр . | Лисенко О І . .
Утв . | Лисенко О . М | .

Н Т У У " К П І " ФЕЛ, гр. ДК-21
