Riconec/ESP8266-Wi-Fi-RFID/PCB/ESP RFID/esp_sch.pdf

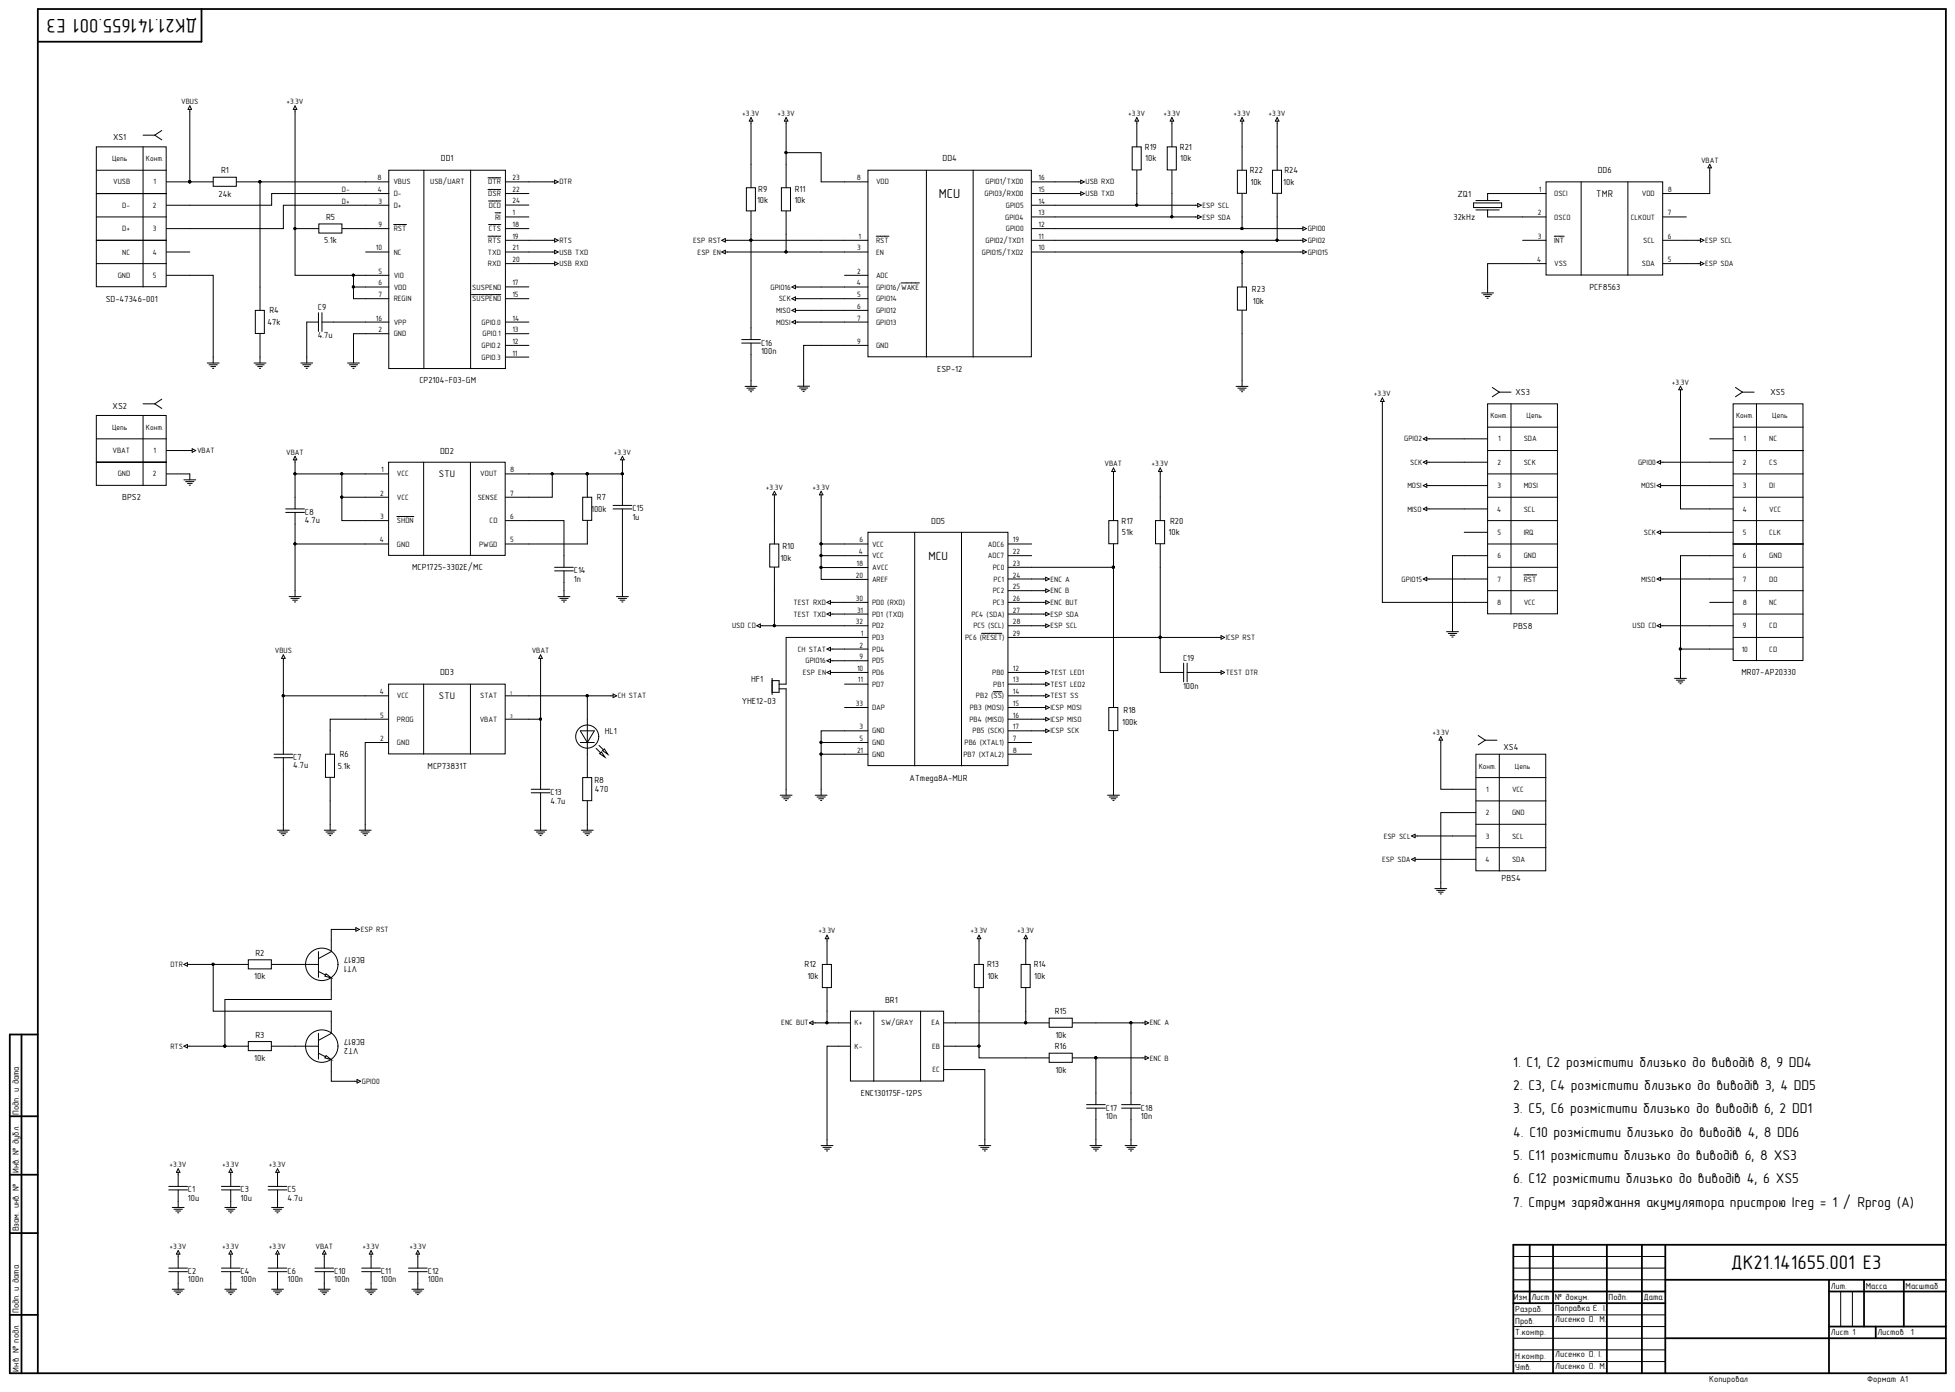
[picture p47: page 1]

Цепь | Конт | .

VBA T | 12

TEST LED1
TEST LED2 ICSP MISO ICSP SCK
TEST SS ICSP MOSI

VCC GND | S T U | STA T VBA T | 3 PROG

GND 21 | 8

Конт | . Цепь
GND VCC

SCL

SDA

істити близько до вивод

Инв. № подл. Инв. № дубл. Подп. и дата Взам. инв. № Подп. и дата

Изм | . Лист | № докум . | Подп . | Дата | | | . | Масса | Масштаб 1

Лит

Разраб . | | Поправка Є . | І .
Пров . | | Лисенко О . М | .
Т .контр . | | | | | Лист | Листов 1

Н .контр . | Лисенко О І . .
Утв . | Лисенко О . М | .

# Board S
