Riconec/ESP8266-Wi-Fi-RFID/PCB/ESP RFID/esp_ch.pdf

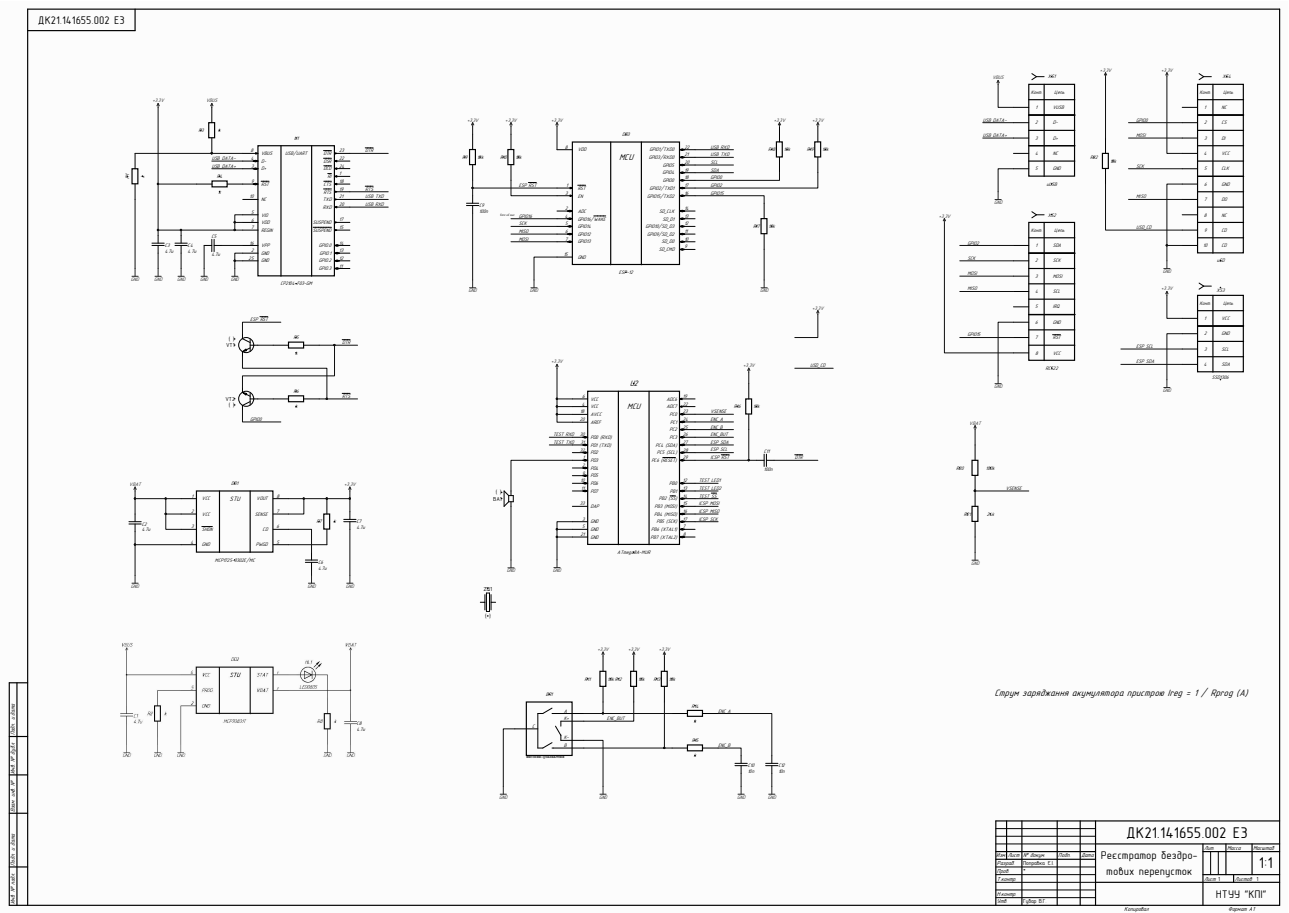
[picture p48: page 1]

Струм заряджання акумулятора пристрою Ireg = 1 / Rprog (A)

1 Инв. № подл. Инв. № дубл. Подп. и дата Взам. инв. № Подп. и дата

Изм. | № докум. | Подп. | Дата Лист | тових перепусток | | 1:1 Реєстратор бездро-
Разраб. | Поправка Є.І.
Пров. | *
Т.контр. | | | | | Лист Листов 1
Н.контр. Утв. | Губар В.Г.

НТУУ "КПІ"
