Riconec/ESP8266-Wi-Fi-RFID/(list of files, drawings)

Other design files:
PCB/ESP RFID/ESP PCB.PcbDoc
PCB/ESP RFID/ESP RFID.PrjPCB
PCB/ESP RFID/ESP_SCH.SchDoc
PCB/ESP RFID/ESP_SCH_debug and testing.SchDoc
PCB/ESP RFID/keoa logo.PcbDoc
PCB/ESP RFID/Librarys/Components GOST.PcbLib
PCB/ESP RFID/Librarys/esp/ESP-12.PcbLib
PCB/ESP RFID/Librarys/esp/ESP-12.SchLib
PCB/ESP RFID/Librarys/GOST SymbolKit.SchLib
PCB/ESP RFID/Librarys/microsd, miniusb/PcbLib1.PcbLib
PCB/ESP RFID/Librarys/microsd, miniusb/Schlib1.SchLib
PCB/ESP RFID/Librarys/mini usb 3d/MOLX-67503-1020_V.PcbLib
PCB/ESP RFID/Librarys/Silicon Labs Interface/Silicon Labs Interface.PcbLib
PCB/ESP RFID/Librarys/Silicon Labs Interface/Silicon Labs Interface.SchLib
PCB/ESP RFID/Librarys/SparkFun-Connectors.PCBLIB
PCB/ESP RFID/Librarys/SparkFun-Connectors.SCHLIB
PCB/ESP RFID/Librarys/Symbols GOST.SchLib
PCB/ESP RFID/logo kpi.PcbDoc
PCB/ESP RFID/PCB ESP.PcbDoc
PCB/ESP RFID/Schematic ESP.SchDoc
PCB/ESP RFID/schematic.SchDoc
