Riconec/ESP8266-Wi-Fi-RFID/(commit log)

2016-05-14 New PCB
    Some trash removed, new PCB project created
    [Components GOST.PcbLib, ESP RFID.PrjPCB, ESP-12.PcbLib, ESP-12.SchLib, GOST SymbolKit.SchLib, MOLX-67503-1020_V.PcbLib, PCB ESP.PcbDoc, PcbLib1.PcbLib]
2016-05-14 Removed trash
    removed trash, clean up, etc
    [Components GOST.PcbLib, ESP RFID.PrjPCB, SCH_ugp.SchLib, Silicon Labs Interface.PcbLib, Silicon Labs Interface.SchLib, Symbols GOST.SchLib]
2016-05-14 update
    new schematic, update on GOST UGO, new components
    [ESP RFID.PrjPCB, ESP-12.PcbLib, ESP-12.SchLib, ESP_SCH.SchDoc, Schematic ESP.SchDoc, Symbols GOST.SchLib]
2016-05-14 upd schematic
    new schematic. new components, new ideas
    [Components GOST.PcbLib, ESP RFID.PrjPCB, ESP_SCH.SchDoc, SparkFun-Connectors.PCBLIB, SparkFun-Connectors.SCHLIB, Symbols GOST.SchLib]
2016-05-14 Schematic update
    Close to v1.0b. Added encoder, second MCU (ATTiny85 or equal), almost
    all ESP's GPIO used already.
    [Components GOST.PcbLib, ESP_SCH.SchDoc, Symbols GOST.SchLib]
2016-05-15 update shcematic
    new 2nd mcu used as peripheral controller as i2c slave device
    [Components GOST.PcbLib, ESP RFID.PrjPCB, ESP_SCH.SchDoc, ESP_SCH_debug and testing.SchDoc, Symbols GOST.SchLib]
2016-05-15 upd schematic, almost complete
    new mcu as i2c slave. reads battery voltage, controls buzzer, controls
    sd card detection pin, read status of encoder and button. huh...
    [Components GOST.PcbLib, ESP RFID.PrjPCB, ESP_SCH.CSV, ESP_SCH.SchDoc, ESP_SCH_debug and testing.SchDoc, GOST SymbolKit.SchLib, Symbols GOST.SchLib]
2016-05-18 shematic final
    many ERC changes
    [ESP RFID.PrjPCB, ESP_SCH.SchDoc, ESP_SCH_debug and testing.SchDoc, Symbols GOST.SchLib]
2016-05-20 new pcb
    new pcb, bugs fixed
    [Components GOST.PcbLib, ESP PCB.PcbDoc, ESP RFID.PrjPCB, ESP_SCH.SchDoc, ESP_SCH_debug and testing.SchDoc, Symbols GOST.SchLib]
2016-05-20 components placed
    ready to route
    [Components GOST.PcbLib, ESP PCB.PcbDoc, ESP_SCH.SchDoc, ESP_SCH_debug and testing.SchDoc, Symbols GOST.SchLib]
2016-05-20 kek update
    [ESP RFID.PrjPCB]
2016-05-20 upd
    1 wire unrouted
    [ESP PCB.PcbDoc, ESP_SCH.SchDoc, ESP_SCH_debug and testing.SchDoc]
2016-05-22 board routed
    wtf is going on
    [Components GOST.PcbLib, ESP PCB.PcbDoc, ESP RFID.PrjPCB, ESP_SCH.SchDoc, ESP_SCH_debug and testing.SchDoc, Symbols GOST.SchLib]
2016-05-23 general cleanup, bugs fixed
    general cleanup, bugs fixed
    [ESP PCB.PcbDoc]
2016-05-23 some changes
    added mount holes, added logos, added vias connecting poligons. simplier
    PCB shape
    [ESP PCB.PcbDoc, ESP RFID.PrjPCB, keoa logo.PcbDoc, logo kpi.PcbDoc]
2016-05-24 one net corrected, pcb fab request
    [ESP PCB.PcbDoc, ESP_SCH.SchDoc]
2016-05-29 added GOST and other docs
    huh...
    [constr.dwg, layout_recover.dwg, РОЗРАХУНОК.xlsx, вес платы в сборе.xlsx, перелік.xlsx]
